w-dee/OneKeyKB/hw/hw.kicad_pcb

## KiCad design hw/hw.kicad_pcb (2024-12-21)

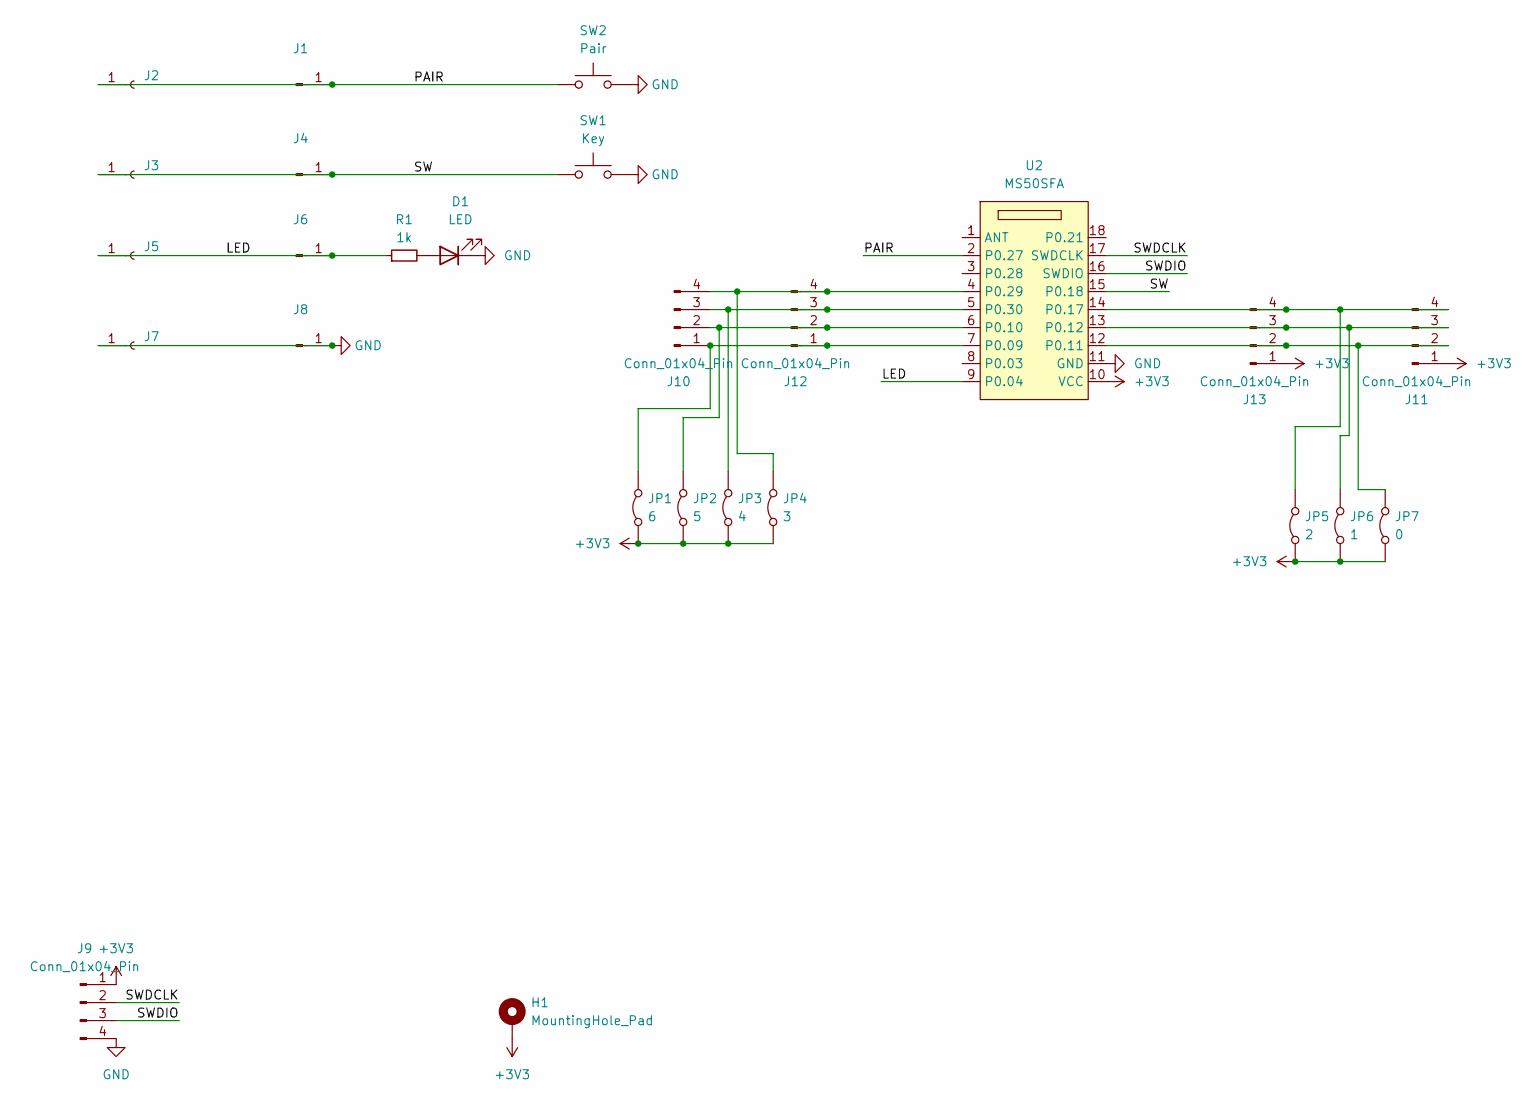
[picture p1: schematic hw.kicad_sch]

Parts:
D1: LED; LED_0603_1608Metric_Pad1.05x0.95mm_HandSolder
H1: MountingHole_Pad; finger_hole_8.0x0.8
J1, J4, J6, J8: Conn_01x02_Pin; PinHeader_1x01_P2.54mm_Vertical
J2, J3, J5, J7: Conn_01x02_Socket; PinSocket_1x01_P2.54mm_Vertical
J9, J10, J11: Conn_01x04_Pin; PinHeader_1x04_P2.54mm_Vertical
J12, J13: Conn_01x04_Pin; PinSocket_1x04_P2.54mm_Vertical
JP1: 6; SolderJumper-2_P1.3mm_Open_RoundedPad1.0x1.5mm
JP2: 5; SolderJumper-2_P1.3mm_Open_RoundedPad1.0x1.5mm
JP3: 4; SolderJumper-2_P1.3mm_Open_RoundedPad1.0x1.5mm
JP4: 3; SolderJumper-2_P1.3mm_Open_RoundedPad1.0x1.5mm
JP5: 2; SolderJumper-2_P1.3mm_Open_RoundedPad1.0x1.5mm
JP6: 1; SolderJumper-2_P1.3mm_Open_RoundedPad1.0x1.5mm
JP7: 0; SolderJumper-2_P1.3mm_Open_RoundedPad1.0x1.5mm
R1: 1k; R_0603_1608Metric_Pad0.98x0.95mm_HandSolder
SW1: Key; SW_Cherry_MX_1.00u_PCB
SW2: Pair; TACT_SW_SMD_Panasonic-EVPAWBD2A
U2: MS50SFA

Connections:
+3V3: H1.1, J9.1, J11.1, J13.1, JP1.1 (A), JP2.1 (A), JP3.1 (A), JP4.1 (A), JP5.1 (A), JP6.1 (A), JP7.1 (A), U2.10 (VCC)
/LED: J5.1, J6.1, R1.1, U2.9 (P0.04)
/PAIR: J1.1, J2.1, SW2.1, U2.2 (P0.27)
/SW: J3.1, J4.1, SW1.1, U2.15 (P0.18)
/SWDCLK: J9.2, U2.17 (SWDCLK)
/SWDIO: J9.3, U2.16 (SWDIO)
GND: D1.1 (K), J7.1, J8.1, J9.4, SW1.2, SW2.2, U2.11 (GND)
unnamed: D1.2 (A), R1.2
unnamed: J10.1, J12.1, JP1.2 (B), U2.7 (P0.09)
unnamed: J10.2, J12.2, JP2.2 (B), U2.6 (P0.10)
unnamed: J10.3, J12.3, JP3.2 (B), U2.5 (P0.30)
unnamed: J10.4, J12.4, JP4.2 (B), U2.4 (P0.29)
unnamed: J11.2, J13.2, JP7.2 (B), U2.12 (P0.11)
unnamed: J11.3, J13.3, JP6.2 (B), U2.13 (P0.12)
unnamed: J11.4, J13.4, JP5.2 (B), U2.14 (P0.17)

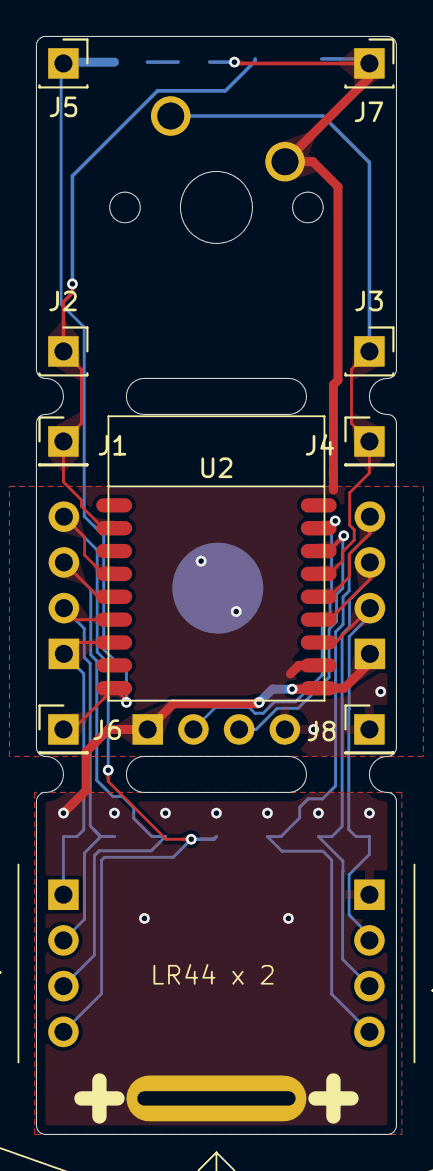
[picture p2: board hw.kicad_pcb from above]

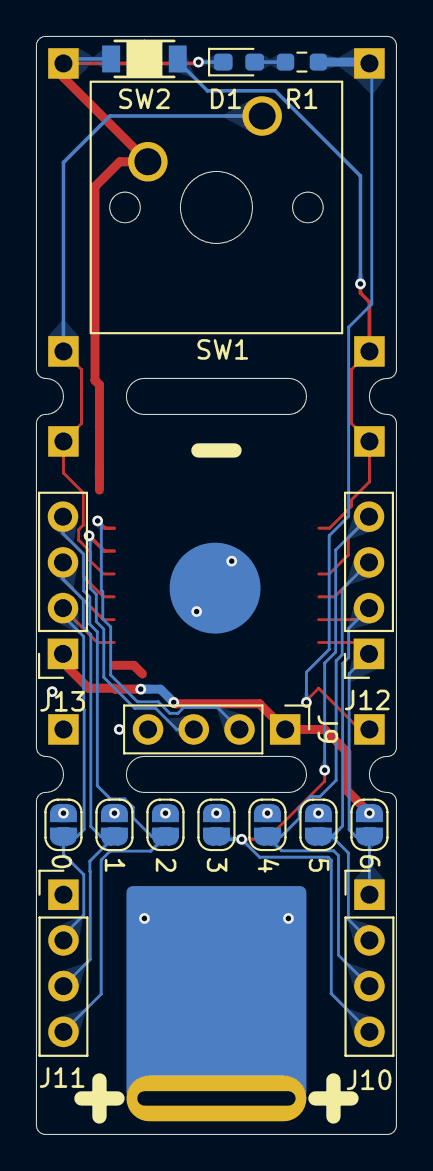
[picture p3: board hw.kicad_pcb from below]

Board: 2 copper layers, 20.0 x 61.0 mm, 26 parts (17 on the bottom side), 15 nets.
