w-dee/OneKeyKB/fw/fw0/src/includes.h

#ifndef INCLUDES_H_
#define INCLUDES_H_

#include <zephyr/types.h>
#include <stddef.h>
#include <errno.h>
#include <zephyr/sys/printk.h>
#include <zephyr/sys/byteorder.h>
#include <zephyr/kernel.h>
#include <zephyr/drivers/gpio.h>
#include <soc.h>
#include <zephyr/settings/settings.h>

#include <zephyr/bluetooth/bluetooth.h>
#include <zephyr/bluetooth/hci.h>
#include <zephyr/bluetooth/conn.h>
#include <zephyr/bluetooth/uuid.h>
#include <zephyr/bluetooth/gatt.h>
#include <zephyr/bluetooth/gap.h>


#include <zephyr/bluetooth/services/bas.h>
#include <bluetooth/services/hids.h>
#include <zephyr/bluetooth/services/dis.h>

#endif /* INCLUDES_H_ */
